maholli/SAM32/hardware/README.md

## [⭐ See the SAM32 Guide for tutorials, design resources, and more!](https://www.notion.so/maholli/SAM32-Guides-6b7e8ca318ff49418eec16e975d98f5d)

<p align="middle">
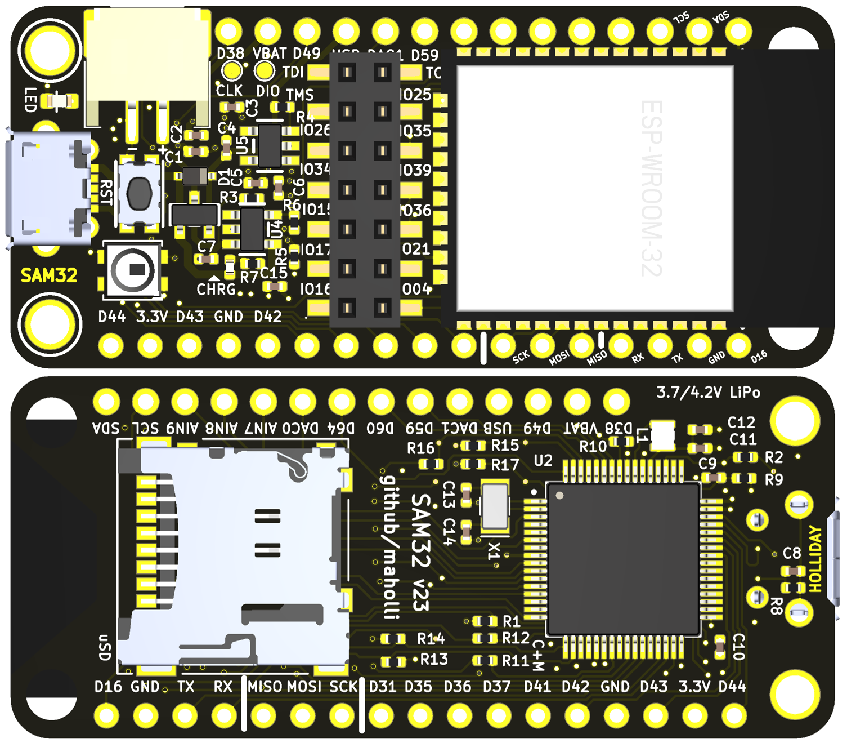
[picture p5: references/board.png]
  
</p>
