maholli/SAM32/firmware/esp32_firmware/ESP32SPI/README.md

## Using the ESP32 as a simple/effective SPI wifi device

See the SAM32 tutorial: [📡 Programming the ESP32 as WiFi Co-Processor](https://maholli.com/Programming-the-ESP32-as-WiFi-Co-Processor-b0de7a169f3a473aa85282cb409dfc21)
