maholli/SAM32/hardware/SAM32_v22/README.md

#### See [https://github.com/maholli/SAM32/blob/master/hardware/SAM32.pdf](https://github.com/maholli/SAM32/blob/master/hardware/SAM32.pdf) to view the schematic in your browser
----
#### interactive BOM: https://maholli.github.io/SAM32/v22

<p align="middle">
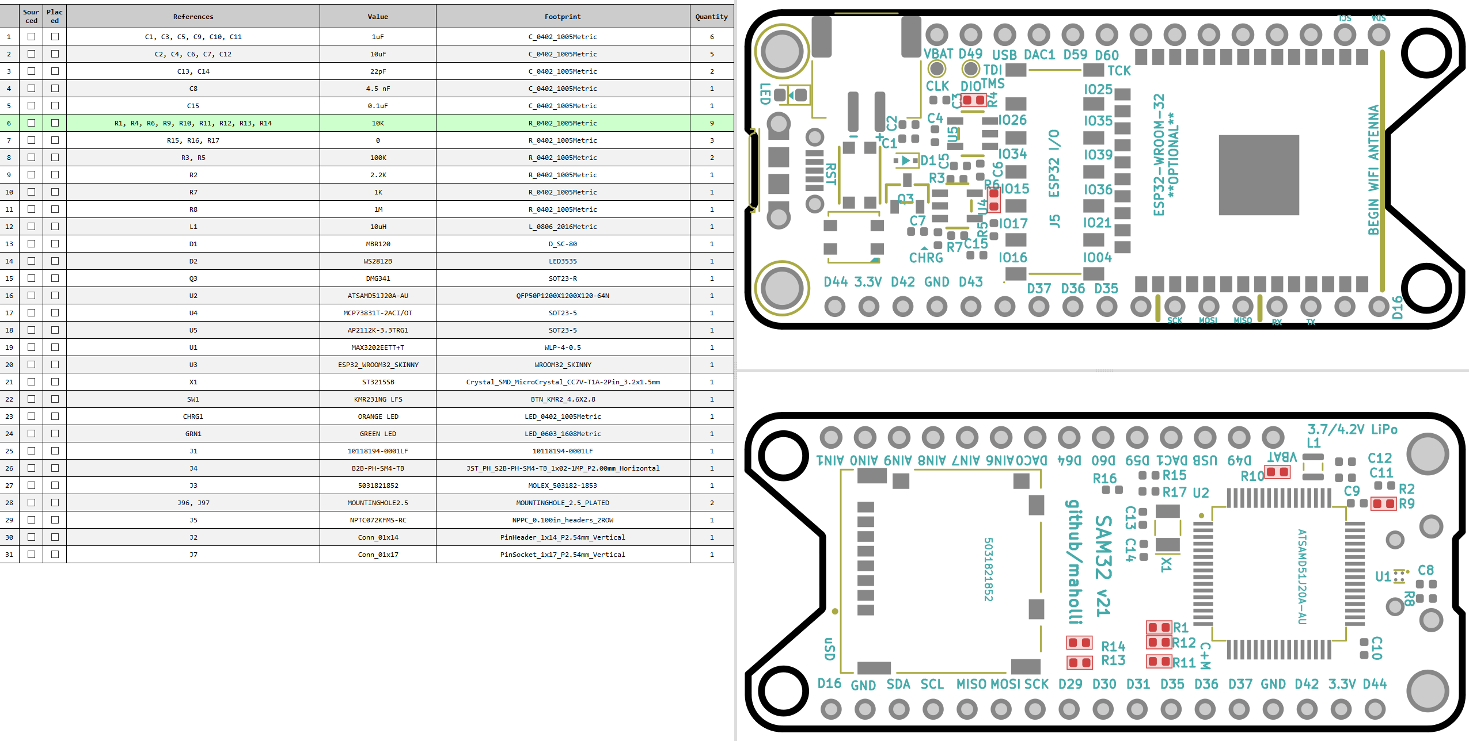
[picture p6: docs/interactiveBOM.PNG]
  
</p>
