maholli/SAM32/references/boardv2.PNG

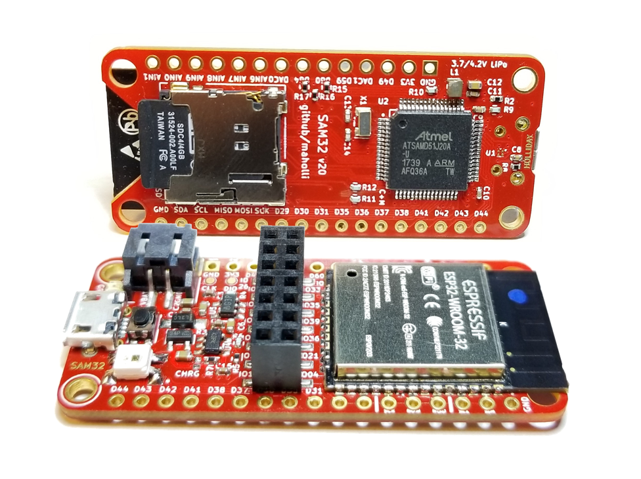
references/boardv2.PNG
