maholli/SAM32/references/doneCompiling.PNG

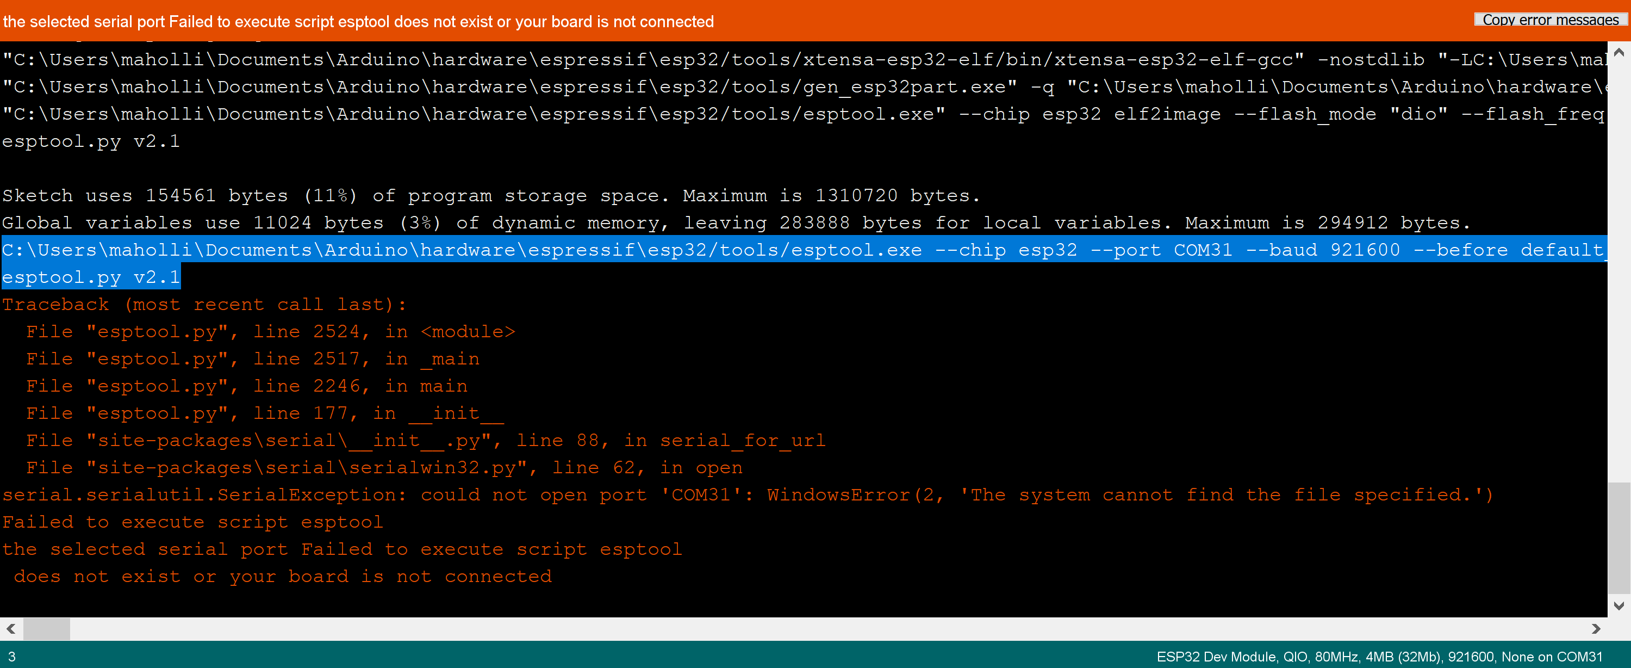
references/doneCompiling.PNG
