maholli/SAM32/references/fileHunting.PNG

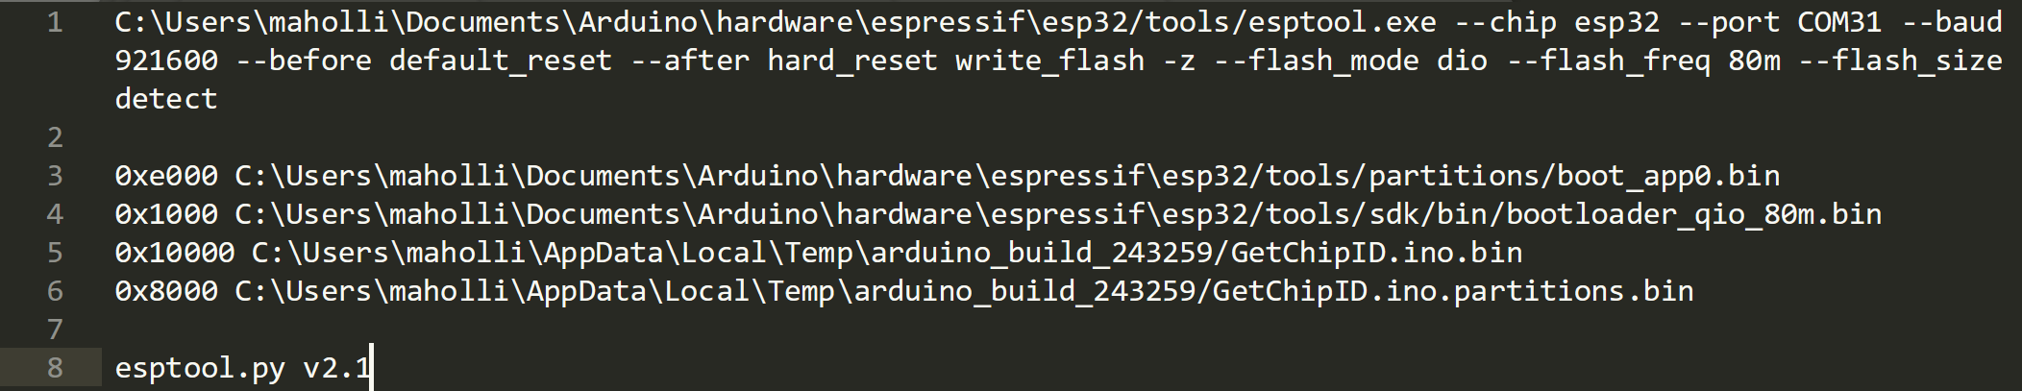
references/fileHunting.PNG
