maholli/SAM32/references/pinout.PNG

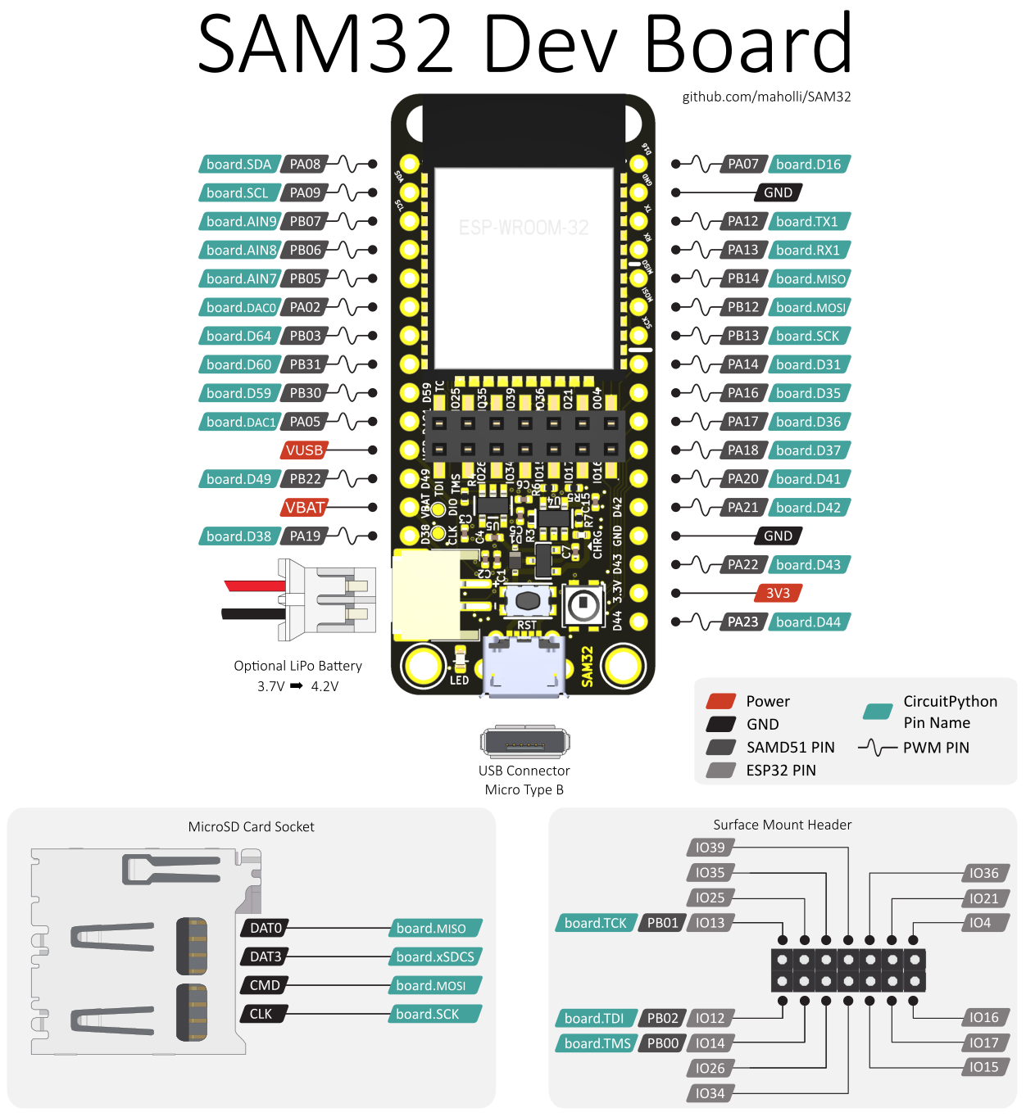
references/pinout.PNG
