maholli/SAM32/references/toolsMenu.PNG

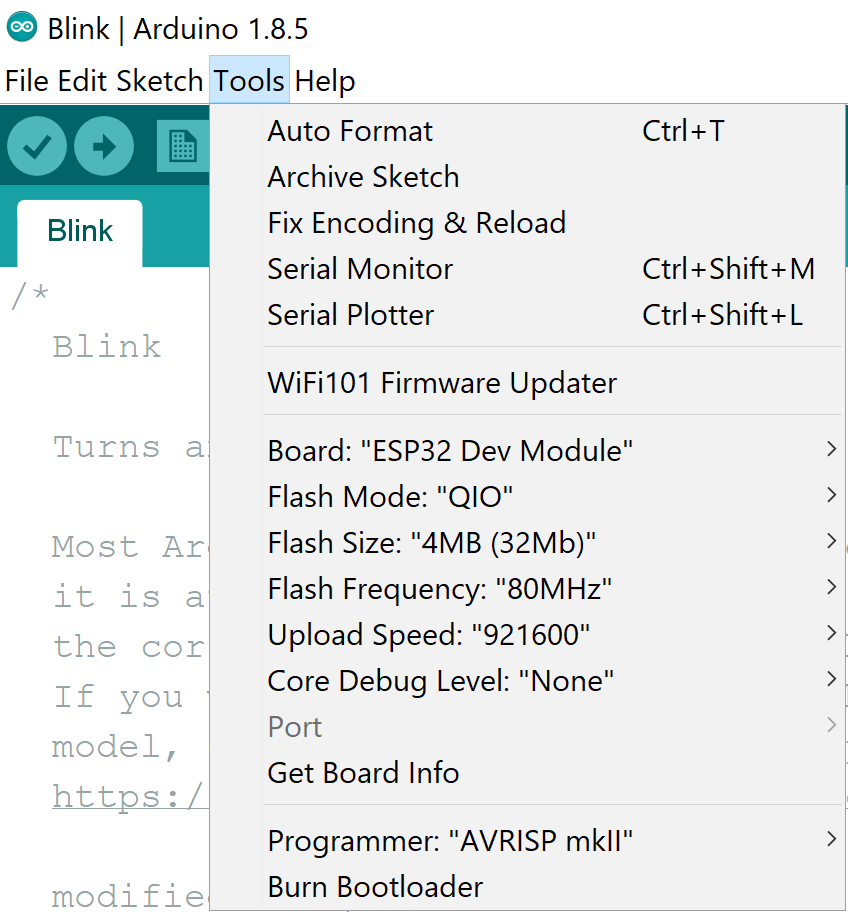
references/toolsMenu.PNG
