maholli/SAM32/references/wroom_pinout.png

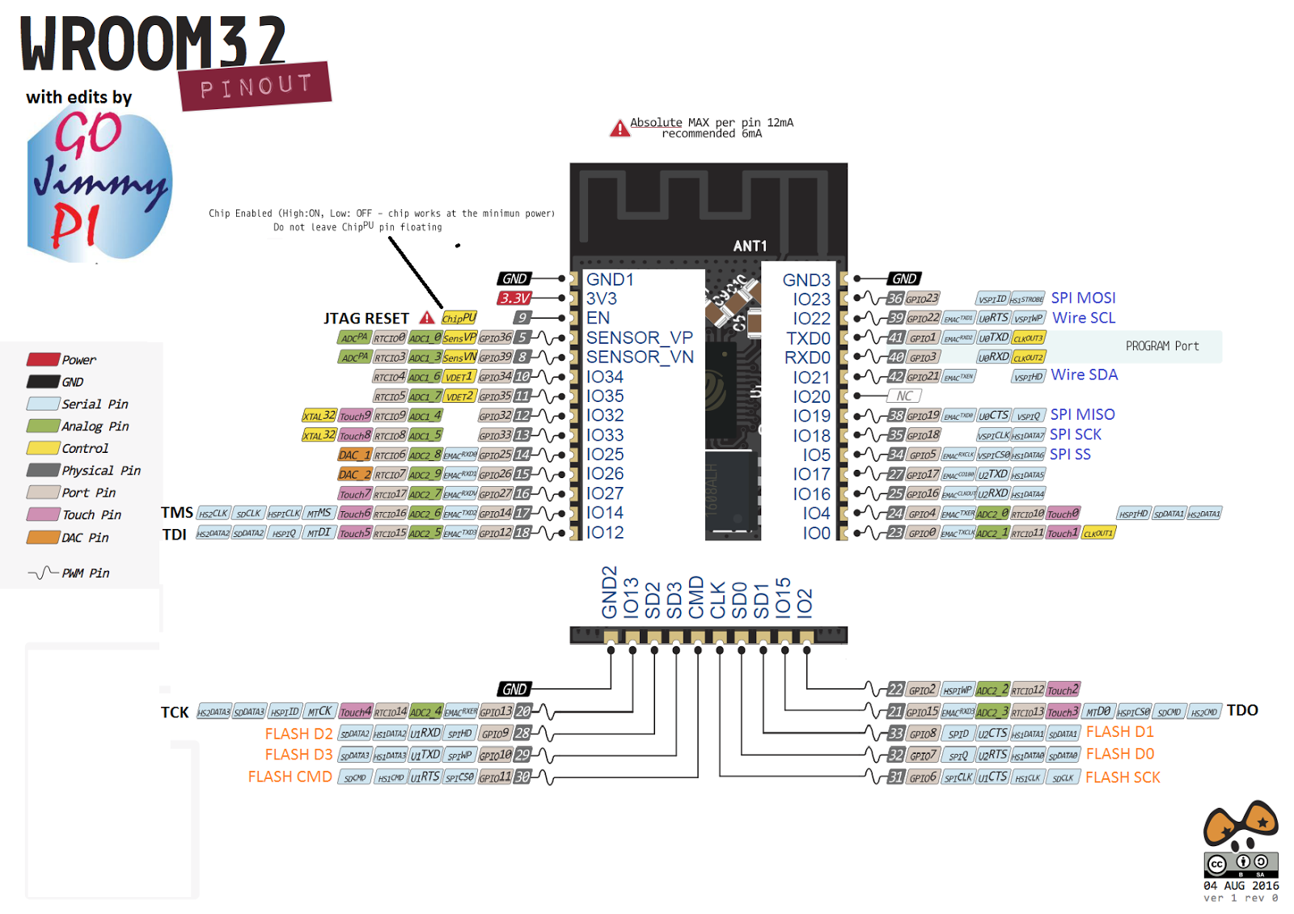
references/wroom_pinout.png
