maholli/SAM32/(threads)

Thread 1 (2019-01-06):

AMPY access to SD and ESP (through SAMD)

maholli, 2019-01-06:

maholli, 2019-01-07:
Goal is to be able to load files to SAMD, esp32, or SD card via adafruit's ampy tool: https://github.com/adafruit/ampy

Currently works with SAMD without issue

Thread 13 (2019-01-06):

Camera Interface

maholli, 2019-01-06:
(SAMD Parallel Capture Control)
* need more RAM to buffer entire image?
   * can we just use direct-memory-access (DMA)?
* What camera module?
   * preferred -> OVM9724
   * easy ->OV7670

maholli, 2019-01-06:
This capability is made possible by the "parallel capture control" hardware on the SAMD51. See
[TN_158_What_Is_The_Camera_Parallel_Interface.pdf](https://github.com/maholli/SAM32/files/2731009/TN_158_What_Is_The_Camera_Parallel_Interface.pdf) for general description of the interface

maholli, 2019-01-06:
https://github.com/adafruit/SAMD51-Camera-Demo may be a good place to start.

Thread 3 (2019-01-06):

Add visual distinction between SAMD REPL and ESP32 REPL (in serial terminal)

maholli, 2019-01-06:

maholli, 2019-01-23:
https://github.com/adafruit/circuitpython/blob/master/py/repl.c might be a good place to look

Thread 4 (2019-01-06):

Confirm SAM32 working on MacOS

maholli, 2019-01-06:
symptoms: circuitpython on firmware_v1e.uf2 was unable to communicate with MacOS (while mounted as CIRCUITPY device).
* CIRCUITPY would present itself, but was not responsive and eventually disappear.
* MacOS *could* communicate with the board in bootloader mode (mounted as SAM32BOOT)

maholli, 2019-01-07:
need someone on MacOS to try communicating with a SAM32 board running firmware_v1g.uf2 or later and report their experience.

maholli, 2019-01-23:
confirmed v2a with bootloader working on MacOS

Closed 2019-01-23.

Thread 5 (2019-01-06):

Add Ctrl+..... commands for uart-bridge mode

maholli, 2019-01-06:

maholli, 2019-01-23:
https://github.com/adafruit/circuitpython/blob/master/py/repl.c might be a good place to look

Thread 7 (2019-01-06):

SD Card filesystem access

maholli, 2019-01-06:
- [x] via SAMD51 SPI
- [x] via ESP32 SPI

maholli, 2019-01-08:
## mounting an SD card on the ESP32 (SAM32v1):

1. set SD_CS low in SAMD51 main.
2. enter the esp32 REPL prompt. Current (sketchy) method is using the attached main.py
[main.py.txt](https://github.com/maholli/SAM32/files/2738494/main.py.txt)

```
import uos
uos.sdconfig(uos.SDMODE_SPI, clk=5, mosi=18, miso=19, cs=14, maxspeed=16)
import os
os.mountsd(True)
os.listdir('/sd')
```

maholli, 2019-01-08:
## running files on ESP32 from SD card

1. Save desired file to sd card (externally)
2. boot with attached main.py [main.py.txt](https://github.com/maholli/SAM32/files/2738500/main.py.txt)
3. mount sd like so:
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
4. run os.getcwd() and make sure you're in /sd, otherwise do os.chdir('/sd')
5. now you you can do: import FILENAMEHERE.py

Thread 15 (2019-01-21):

Investigate premature UART buffer filling on v2

maholli, 2019-01-21:
v2a seems to be missing the first few bits of UART messages, which shouldn't be occurring unless the buffer is tossing them out?

maholli, 2019-01-22:
thinking about it more... maybe it's because I'm relying on the internal pull-up on the samd51 Tx pin. When the micro is reset, this will float the Tx, causing the esp to respond with who-knows-what.

will try and put UART init closer to the time the TxRx pins are used.

maholli, 2019-01-23:
Solved. Was initializing UART and then doing a bunch of SPI sd card stuff. Everything prints correctly with the latest esp_talk.py example

Closed 2019-01-23.

Thread 17 (2019-01-24):

Test for possible issues when both ESP and SAMD try to access SD card concurrently

gabebuckmaster, 2019-01-24:
Both SAMD and ESP are configured as masters on the SPI bus to the SD card. If, through software mis-configuration, they both try to access the SD card at the same time, it may cause hardware issues. Test this and see if it actually causes a problem. If it does, a series resistor in the SPI lines from each microcontroller may solve the issue.

Thread 19 (2019-02-06):

Try running ESP32 via SPI

maholli, 2019-02-06:
As noted here: https://github.com/adafruit/uf2-samdx1/pull/45#issuecomment-460876018 by ladyada 😱

The ESP32 can run firmware that allows us to interact with it from the SAMD51 using SPI. For simple tasks, this provides internet access to the SAM32 without having to context-switch to the ESP32. Cool! 💯

For further implementation, check out: https://github.com/ladyada/Adafruit_CircuitPython_PyPortal/blob/master/adafruit_pyportal.py

maholli, 2019-05-09:
This has been implimented. See [SAM32/firmware/esp32_firmware/ESP32SPI](https://github.com/maholli/SAM32/tree/master/firmware/esp32_firmware/ESP32SPI) for details.

Closed 2019-05-09.

Thread 20 (2019-02-10):

BUG: I2C labeled incorrectly on silkscreen

maholli, 2019-02-10:
The pins labeled SDA and SCL on SAM32_v2 are incorrect. They're still perfectly fine GPIO, but they wont work for I2C if you try to assign them as such.

alternative I2C pins broken out to headers on the SAM32 boards are:

| SDA    | SCL    | SERCOM # | SERCOM GROUP |
| ------ | ------ | -------- | ------------ |
| PAD[0] | PAD[1] |          |              |
| PA04   | PA05   | 0        | D            |
| PA08   | PA09   | 0        | C            |
| PA09   | PA08   | 2        | D            |
| PA12   | PA13   | 2        | C            |
| PA16   | PA17   | 1        | C            |
| PA17   | PA16   | 3        | D            |
| PA22   | PA23   | 3        | C            |

note: these pins won't have on-board pull-up resistors

maholli, 2019-02-22:
fixed on v22

Closed 2019-02-22.

Thread 23 (2019-09-25):

SPI issue when ESP32 coprocessor is active

maholli, 2019-09-25:
There's a known issue with NINA firmware on the SAM32v2.4 causing it to dominate the SPI bus. This causes intermittent issues with concurrent ESP32 and SD card access (for example).

Adafruit has designed a fix for their boards and the same fix will be implemented in v2.5. See pic below from the Airlift express for an example of properly putting the MISO pin into a tri-state using a buffer gate:
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

maholli, 2019-11-25:
Solved with version v25 onward.
