maholli/SAM32/hardware/SAM32_v26/SAM32v26.pdf

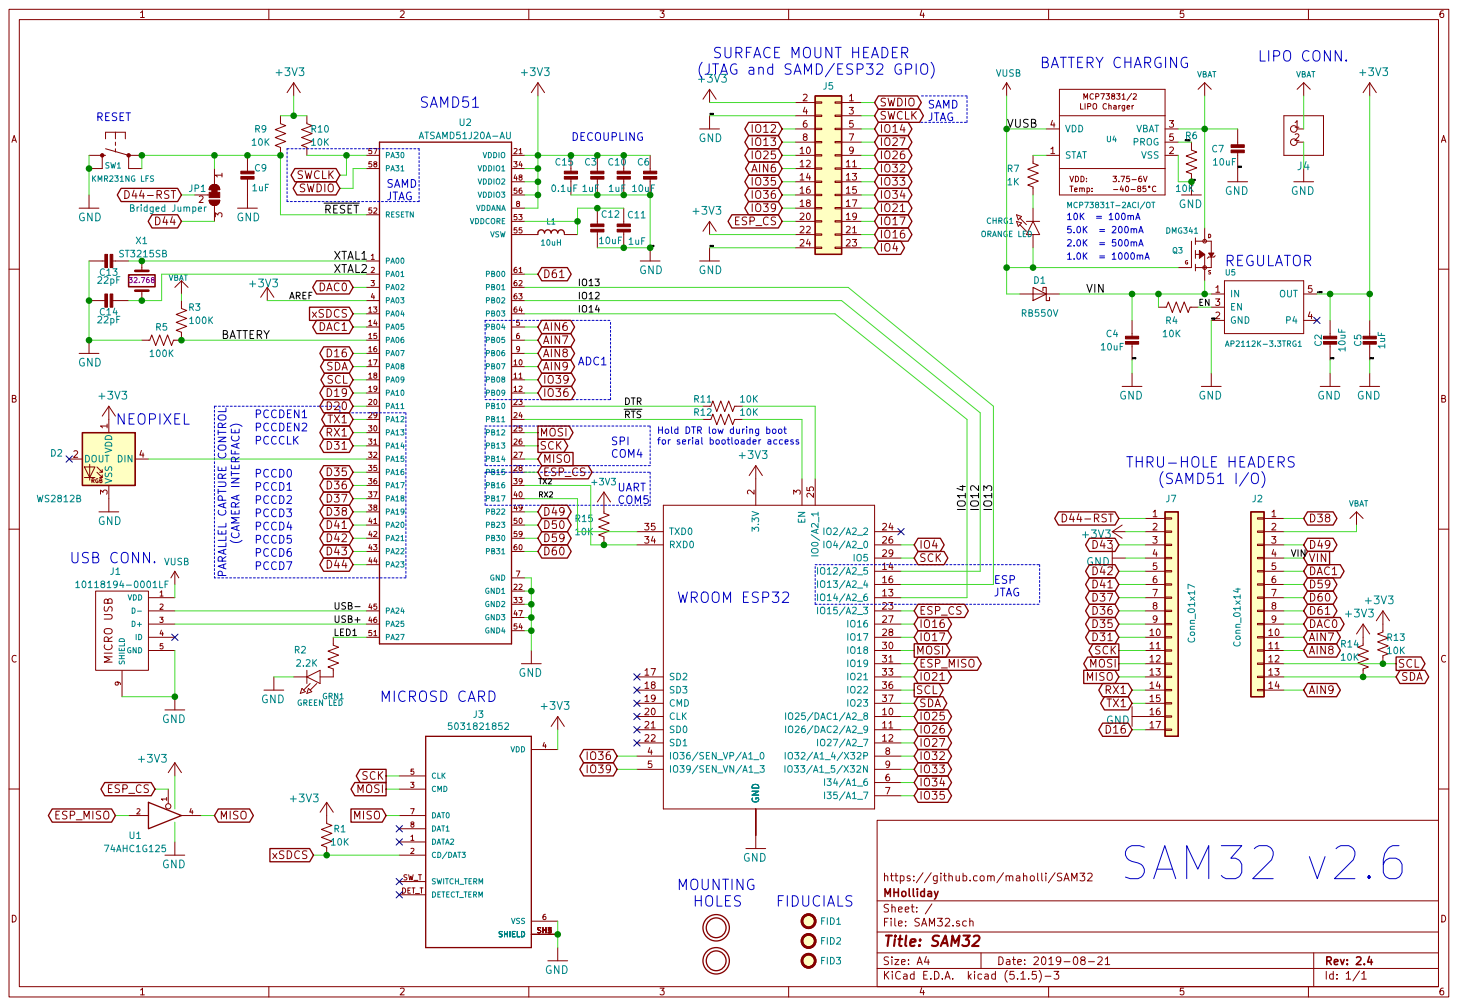
[picture p13: page 1]

SURFACE MOUNT HEADER
(JTAG and SAMD/ESP32 GPIO)

SCL SCK MOSI MISO

for serial bootloader access PARALLEL CAPTURE CONTROL

Hold DTR low during boot

File: SAM32.sch Sheet: / MHolliday
