maholli/SAM32/hardware/SAM32_v23/SAM32.pdf

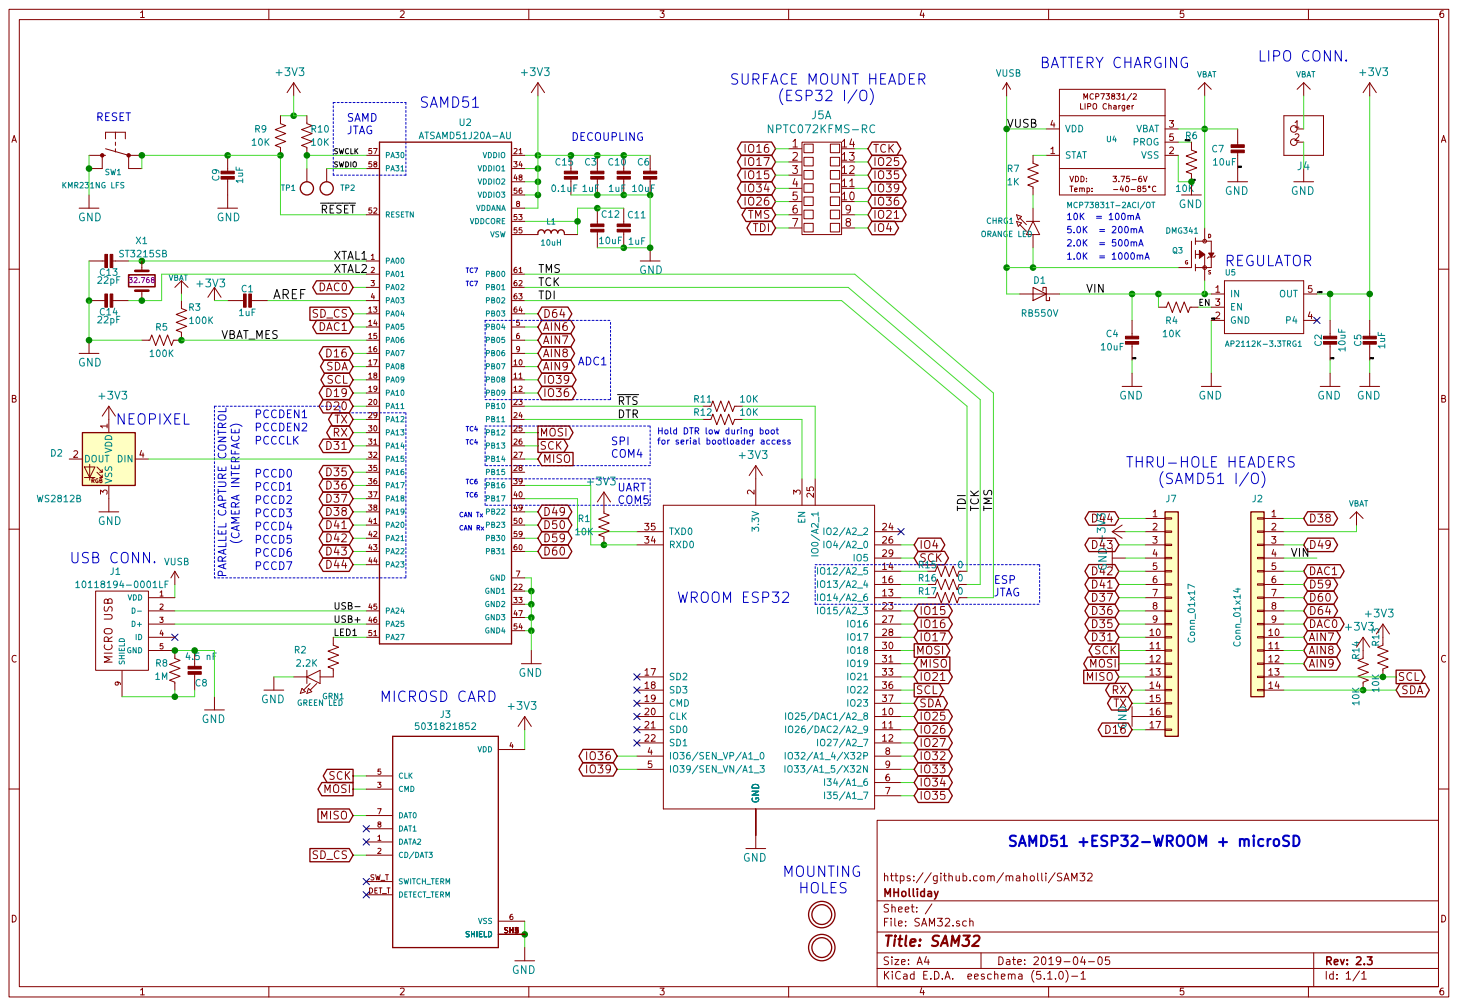
[picture p14: page 1]

VBAT GND LIPO CONN.

SDA
SCL SCK MOSI MISO

for serial bootloader access NEOPIXEL
RGB VDD

https://github.com/maholli/SAM32
File: SAM32.sch Sheet: / MHolliday
