maholli/SAM32/hardware/SAM32_v21/SAM32.pdf

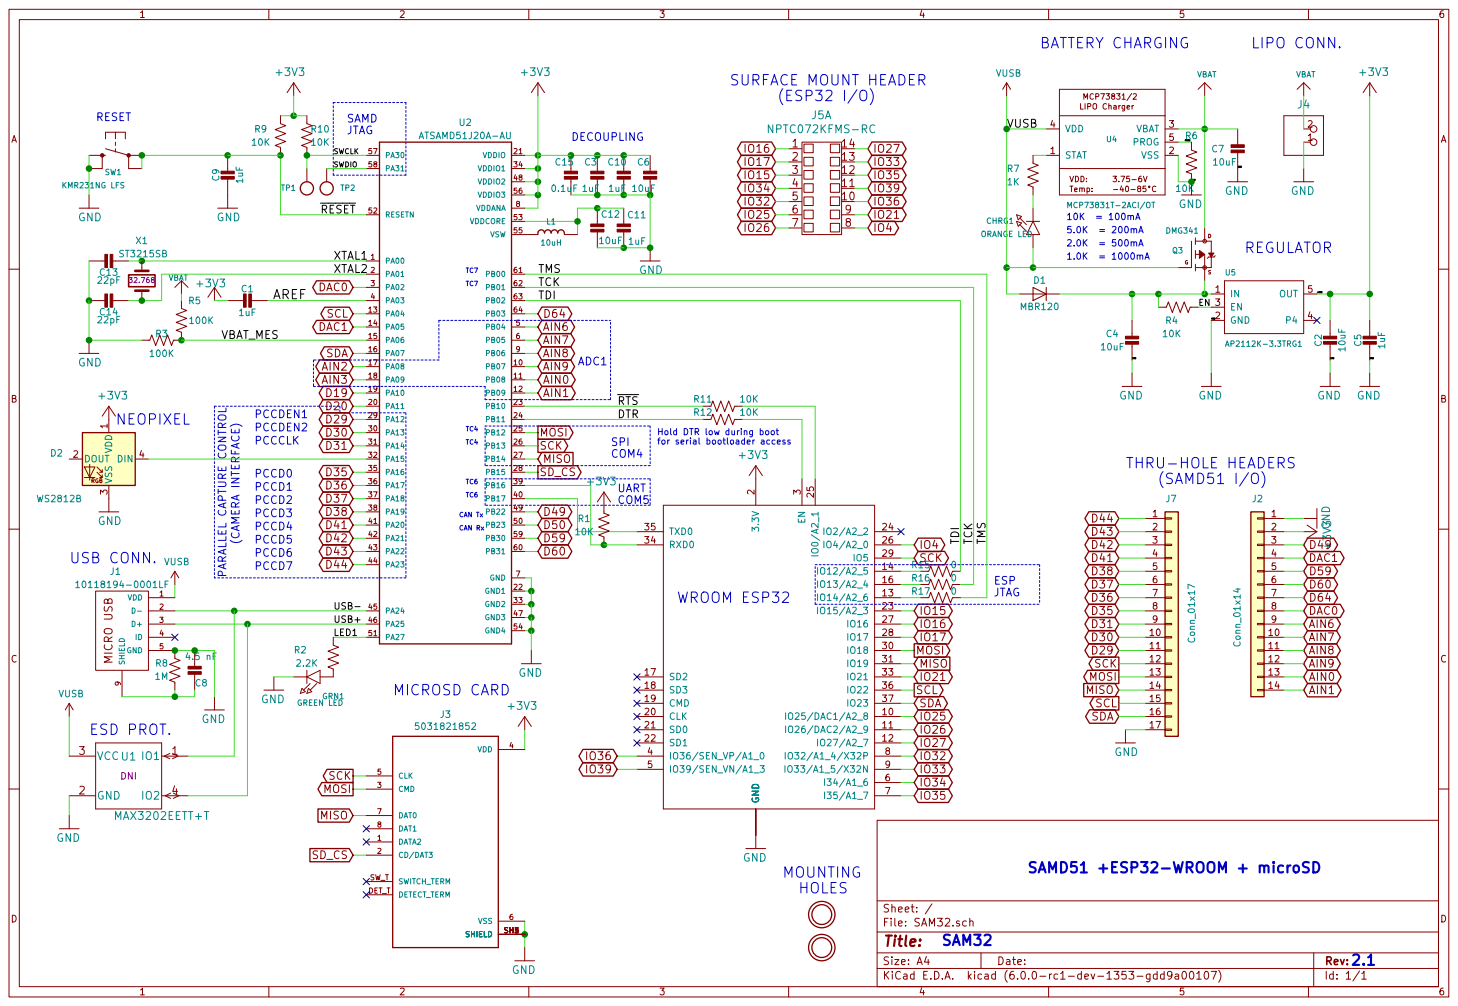
[picture p15: page 1]

VBAT GND LIPO CONN. TDI TCK

TC6 TC6 DAC0 DAC1
SCL SCK MOSI MISO

for serial bootloader access NEOPIXEL
RGB VDD

Id: 1/1 Title: File: SAM32.sch Sheet: /
