maholli/SAM32/hardware/SAM32_v24/SAM32.pdf

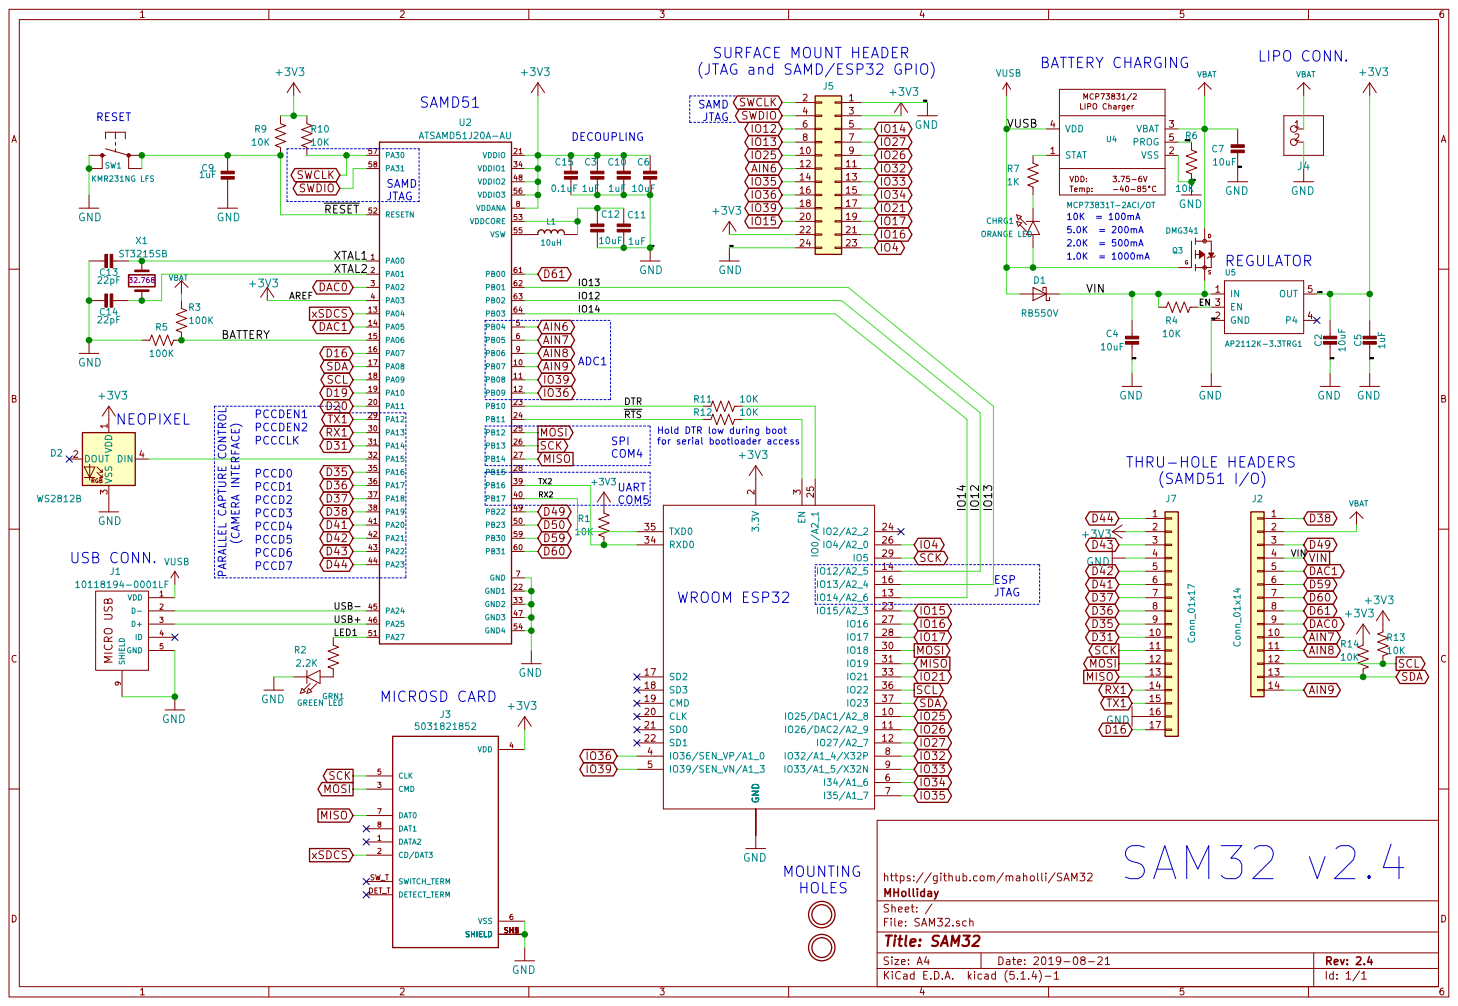
[picture p16: page 1]

Hold DTR low during boot

https://github.com/maholli/SAM32
File: SAM32.sch Sheet: / MHolliday
