maholli/SAM32/firmware/esp32_firmware/ESP32SPI/for sam32/esp32spi_prog.py

import time
import board
import busio, supervisor, os

from digitalio import DigitalInOut, Direction # pylint: disable=unused-import
import adafruit_miniesptool

print("ESP32 mini prog")

resetpin = DigitalInOut(board.RTS)
gpio0pin = DigitalInOut(board.DTR)
resetpin.direction = Direction.OUTPUT
gpio0pin.direction = Direction.OUTPUT

resetpin.value = 1
gpio0pin.value = 1

import adafruit_sdcard, storage

spi = busio.SPI(board.SCK, board.MOSI, board.MISO)
cs = DigitalInOut(board.xSDCS)
sdcard = adafruit_sdcard.SDCard(spi, cs)
vfs = storage.VfsFat(sdcard)
storage.mount(vfs, "/sd")

def print_directory(path, tabs=0):
    for file in os.listdir(path):
        stats = os.stat(path + "/" + file)
        filesize = stats[6]
        isdir = stats[0] & 0x4000
        if filesize < 1000:
            sizestr = str(filesize) + " by"
        elif filesize < 1000000:
            sizestr = "%0.1f KB" % (filesize / 1000)
        else:
            sizestr = "%0.1f MB" % (filesize / 1000000)
        prettyprintname = ""
        for _ in range(tabs):
            prettyprintname += "   "
        prettyprintname += file
        if isdir:
            prettyprintname += "/"
        print('{0:<40} Size: {1:>10}'.format(prettyprintname, sizestr))
        # recursively print directory contents
        if isdir:
            print_directory(path + "/" + file, tabs + 1)

time.sleep(0.5)
uart = busio.UART(board.TX2, board.RX2, baudrate=115200, timeout=100)
esptool = adafruit_miniesptool.miniesptool(uart, gpio0pin, resetpin, flashsize=4*1024*1024)
esptool.debug = True
time.sleep(0.5)

esptool.sync()

print("Synced")
print("Found:", esptool.chip_name)
if esptool.chip_name != "ESP32":
    raise RuntimeError("for ESP32 only")
esptool.baudrate = 912600
print("MAC ADDR: ", [hex(i) for i in esptool.mac_addr])

esptool.flash_file('/sd/NINA_W102-1.3.0_sam32.bin', 0x00)

esptool.reset()
time.sleep(0.5)
