maholli/SAM32/(commit log)

2018-10-24 initial commit w/ datasheets
    [lab64_SAM32.kicad_pcb, lab64_SAM32.sch]
2018-10-24 0OHM jumpers on ESP32 TxRx
    [lab64_SAM32.sch]
2018-10-25 1st placement + repo clean
    [file5BDDF2AB.sch, file5BE11DCB.sch, lab64_SAM32.kicad_pcb, lab64_SAM32.sch, mpconfigboard.h.txt, mpconfigboard.mk.txt, samd51_pinout64.xlsx, uf2-samdx1_BOARD_CONFIG.h.txt]
2018-10-25 minor schematic cleanup
    [file5BDDF2AB.sch, file5BE11DCB.sch, lab64_SAM32.sch]
2018-10-26 minor schematic clean-up
    [lab64_SAM32.kicad_pcb, lab64_SAM32.sch]
2018-10-26 major placement and 3D objects
    [lab64_SAM32.kicad_pcb, lab64_SAM32.sch]
2018-10-26 power routed
    [lab64_SAM32.kicad_pcb]
2018-10-26 roughing in critical routes
    [lab64_SAM32.kicad_pcb]
2018-10-26 tweaking critical routes
    [lab64_SAM32.kicad_pcb]
2018-10-26 critical routing finished
    [lab64_SAM32.kicad_pcb, lab64_SAM32.sch]
2018-10-26 small tweaks
    [lab64_SAM32.kicad_pcb]
2018-10-27 roughing in bulk IO
    [lab64_SAM32.kicad_pcb, lab64_SAM32.sch]
2018-10-27 top SMD header routed
    [lab64_SAM32.kicad_pcb, lab64_SAM32.sch]
2018-10-27 done routing, minor cleanup left
    [lab64_SAM32.kicad_pcb, lab64_SAM32.sch]
2018-10-28 routing finished, still need to polish
    [lab64_SAM32.kicad_pcb, lab64_SAM32.sch]
2018-10-28 R and C ref des cleaned up
    [lab64_SAM32.kicad_pcb, lab64_SAM32.sch]
2018-10-28 some silkscreen finished
    [lab64_SAM32.kicad_pcb, lab64_SAM32.sch]
2018-10-28 finished silkscreen + interactive BOM
    [lab64_SAM32.kicad_pcb, lab64_SAM32.sch]
2018-10-28 adding digikey cart export
    [lab64_SAM32_DIGIKEY.csv]
2018-10-28 small readme update
    [lab64_SAM32.sch]
2018-10-28 organizing folders
    [lab64_SAM32_DIGIKEY.csv, samd51_pinout64.xlsx]
2018-10-28 BOM value cleanup
    [lab64_SAM32.kicad_pcb, lab64_SAM32.sch]
2018-10-29 changed board name
    [SAMD-10.kicad_pcb, SAMD-10.sch, lab64_SAM32_DIGIKEY.csv, mpconfigboard.h.txt, mpconfigboard.mk.txt, uf2-samdx1_BOARD_CONFIG.h.txt]
2018-10-29 layout DRC
    [SAMD-10.kicad_pcb]
2018-10-29 updating BOM
2018-10-29 layout review w/ Steve
    [SAMD-10.kicad_pcb, SAMD-10.sch]
2018-10-31 back to SAM32 name
    [SAM32.kicad_pcb, SAM32.sch, SAM32_DIGIKEY.csv]
2018-12-02 adding firmware and board pictures
    [SAM32.kicad_pcb, SAM32.sch]
2018-12-13 updating to v1g - MacOS fix?
    [example.py]
2018-12-28 adding esp32 programming via samd51 & sd card!
2018-12-28 instructions for programming esp32
2018-12-29 updating hardware to v2
    [SAM32.kicad_pcb, SAM32.sch]
2019-01-20 updating esp32 programming scripts
2019-01-21 fixed schematic label + correct firmware
2019-01-21 swapped RTS / DTR labels only
    [SAM32.sch]
2019-01-21 added interactive BOM for v2 board
2019-01-23 updating more documention to v2a
    [SAM32.kicad_pcb, SAM32.sch, SAM32_DIGIKEY.csv, mpconfigboard.h.txt, mpconfigboard.mk.txt, uf2-samdx1_BOARD_CONFIG.h.txt]
2019-01-23 putting board pic back
2019-01-23 unifying footprints
    [SAM32.kicad_pcb, SAM32.sch]
2019-01-23 updated interactive BOM
2019-01-23 adding useful circuitpython libraries
2019-01-23 submodule for circuitpython libs
2019-01-23 adding new board image
2019-01-23 removing old board pic
2019-01-23 silkscreen fix
    [SAM32.kicad_pcb]
2019-02-06 minor tweaks to align with https://github.com/adafruit/uf2-samdx1/pull/45 and https://github.com/adafruit/circuitpython/pull/1523
    Adafruit pull requests:
    1. https://github.com/adafruit/circuitpython/pull/1523
    2. https://github.com/adafruit/uf2-samdx1/pull/45
2019-02-06 easier to find schematic
2019-02-10 clarifying ESP32 programming instructions
2019-02-19 modified board pinout to conform to adafruit feather standard :+1:
    [SAM32.kicad_pcb, SAM32.sch]
2019-02-20 directory for v21 (for reference)
    [SAM32.kicad_pcb, SAM32.sch]
2019-02-20 organizing directories
    [SAM32.kicad_pcb, SAM32.sch]
2019-02-20 fixing v22 interactive BOM link
2019-02-22 v22 cleanup and output files
    [SAM32-B_Mask.gbr, SAM32-B_Paste.gbr, SAM32-B_SilkS.gbr, SAM32-Bottom.gbr, SAM32-Edge_Cuts.gbr, SAM32-F_Mask.gbr, SAM32-F_Paste.gbr, SAM32-F_SilkS.gbr]
2019-02-24 found esp32 programming bug causing OSError.
    See https://github.com/adafruit/Adafruit_CircuitPython_miniesptool/issues/9 for details.
    [esp_prog.py]
2019-02-24 adding ESP32 arduino programming instructions
2019-02-25 ESP32 arduino programming
2019-02-25 adding esp arduino programming file
2019-03-08 minor v2.2 fab tweaks
    [SAM32-B_Mask.gbr, SAM32-B_Paste.gbr, SAM32-B_SilkS.gbr, SAM32-Bottom.gbr, SAM32-Edge_Cuts.gbr, SAM32-F_Mask.gbr, SAM32-F_Paste.gbr, SAM32-F_SilkS.gbr]
2019-05-04 adding v2.3 hardware
    [SAM32.kicad_pcb, SAM32.sch]
2019-05-08 adding esp32SPI firmware and clarification edits on v23 schematic
    [SAM32.sch]
2019-05-09 adding v23 interactive BOM
2019-05-09 adding esp32spi example script
2019-05-15 fixed esp32spi firmware name
    [esp32spi_prog.py]
2019-05-15 updating board images
2019-06-10 making v23 easier to clone and work on locally
    [SAM32.kicad_pcb, SAM32.sch]
2019-06-10 updated board.png
2019-08-22 adding version v2.4
    [SAM32.kicad_pcb, SAM32.sch]
2019-08-22 firmware cleaning and adding firmware_v24
    [SAM32.sch]
2019-09-03 mini-ESP tool for flashing ESP32
2019-11-08 adding v25 which fixes concurrent ESP32/SD Card access
    [SAM32.kicad_pcb, SAM32.sch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]
2019-11-25 adding v26
    [SAM32.kicad_pcb, SAM32.sch]
2019-11-25 updating interactive bom
2020-01-16 adding v2.6 schematic pdf
